ARTS-Laboratory/SCUWLS/system_design/Georgetown/V0.5.2/bill_of_materials.xlsx

Part Designator | Component | manufacturer part number | Amount | Unit | Individual Cost | Total Cost | Vendor 1 | Vendor 2 | Vendor 3 | Vendor 4 | Vendor 5 | Vendor 6
Nano every | Arduino Nano every |  | 1 | Pc | $12.90 | $12.90 | https://www.digikey.com/en/products/detail/arduino/ABX00028/10239971 | https://store-usa.arduino.cc/products/nano-every | https://www.sparkfun.com/arduino-nano-every.html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
P1 (Micro SD card slot) | 112J-TDAR-R01, 9 (8 + 1) Position Card Connector Secure Digital - microSD™ Surface Mount, Right Angle Gold |  | 1 | Pc | $2.52 | $2.52 | https://www.digikey.com/en/products/detail/attend-technology/112J-TDAR-R01/17634680 | https://www.ebay.com/itm/235081679206?chn=ps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
NRF24L01+ | NRF24L01+ 2.4GHz Wireless RF Transceiver Module |  | 1 | Pc | $3.95 | $3.95 | https://protosupplies.com/product/nrf24l01palna-2-4ghz-rf-wireless-module/
U2 (DS3231) | DS3231M+ real-time clock IC |  | 1 | Pc | $11.96 | $11.96 | https://www.digikey.com/en/products/detail/analog-devices-inc-maxim-integrated/DS3231M/2402420
U4 (BME280) | BME280 Pressure, Temperature and Humidity sensor |  | 1 | Pc | $5.26 | $5.26 | https://www.ebay.com/itm/327147846952?_skw=BME280+5+V&itmmeta=01KZVT1RTW26G1WWC3Y7NSNY2T | https://www.amazon.com/Onyehn-Temperature-Humidity-Barometric-Pressure/dp/B07KR24P6P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 | https://www.ebay.com/itm/223602242983?chn=ps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 | https://www.ebay.com/itm/183678893844?chn=ps&google_free_listing_action=view_item&gQT=2 | https://protosupplies.com/product/bme280-i2c-pressure-humidity-temperature-sensor-module/
U3 | Mini Pushbutton Power Switch with Reverse Voltage Protection, LV |  | 1 | Pc | $4.95 | $4.95 | https://www.digikey.com/en/products/detail/pololu/2808/10450608 | https://www.pololu.com/product/2808
N42 permanent magnet | Neodymium Disc Magnet - 1 1/4" Dia x 3/8" Thi |  | 1 | Pc | $15.20 | $15.20 | https://www.kjmagnetics.com/dx46-neodymium-disc-magnet
Ultrasonic sensor | HC-SR04 |  | 1 | Pc | $5.25 | $5.25 | Ultrasonic Distance Sensor - 5V (HC-SR04) (https://www.sparkfun.com/ultrasonic-distance-sensor-hc-sr04.html) | https://www.digikey.com/en/products/detail/adafruit-industries-llc/3942/9658069?gclsrc=aw.ds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 | https://www.ebay.com/itm/192312930293?chn=ps&google_free_listing_action=view_item
2s 7.4V LiPo battery | 2S Lipo Battery 1500mAh 7.4V with Deans Plug, Dim: 69*35*18mm |  | 1 | Pc | $18.00 | $18.00 | https://zeeebattery.com/products/zeee-7-4v-60c-1500mah-2s-lipo-battery-deans-plug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 | https://www.ebay.com/itm/383205406858
CR-1025 3V Li+ coin cell | CR-1025-ND |  | 1 | Pc | $1.09 | $1.09 | CR1025 Jauch Quartz | Battery Products | DigiKey (https://www.digikey.com/en/products/detail/jauch-quartz/CR1025/16399048) | https://www.ebay.com/itm/365610739537?chn=ps&google_free_listing_action=view_item
BT1 (coin cell holder) | BK-870 |  | 1 | Pc | $0.58 | $0.58 | BK-870 MPD (Memory Protection Devices) | Battery Products | DigiKey (https://www.digikey.com/en/products/detail/mpd-memory-protection-devices/bk-870/3829737) | https://www.ebay.com/itm/133891769676?chn=ps&google_free_listing_action=view_item
Q1 | MMBT2222A NPN transistor |  | 1 | pc | $0.14 | $0.14 | https://www.digikey.com/en/products/detail/diotec-semiconductor/MMBT2222A/13163394
PCB stage height v0.5.2 | Main board |  | 1 | Pc | $8.23 | $8.23 | https://oshpark.com/
Micro SD card | 8GB Micro SD Card |  | 1 | Pc | $8.24 | $8.24 | https://www.staples.com/centon-micro-8gb-sdhc-memory-card-uhs1-5-pack-s1-msdhu1-8g-5-b/product_24298979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 | https://www.staples.com/transcend-8gb-microsdhc-memory-card-class-10-ts8gusdhc10/product_IM1LK3226 | https://www.cdwg.com/product/transcend-flash-memory-card-8-gb-microsd/3181432?pfm=srh | https://www.cdwg.com/product/kingston-industrial-flash-memory-card-8-gb-microsdhc-uhs-i/6669743?pfm=srh | https://business.walmart.com/ip/Gigastone-8GB-Micro-SD-Card-FHD-Video-UHS-I-U1-Class-10-Surveillance-Security-Action-Cameras-Drone-Dash-Cams-5-Pack-5x8GB-GS-2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 | https://www.amazon.com/Gigastone-10-Pack-Surveillance-Security-Action/dp/B0876H387X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
SW1 (Slide switch) | 450301014042, Slide Switch SPDT Through Hole |  | 1 | Pc | $2.03 | $2.03 | https://www.digikey.com/en/products/detail/w%C3%BCrth-elektronik/450301014042/5209104 | https://www.mouser.com/ProductDetail/Wurth-Elektronik/450301014042?qs=wr8lucFkNMW0uepaR4R%2Fww%3D%3D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
D2 (LED) | L314ED, 3mm Red LED |  | 1 | Pc | $0.20 | $0.20 | L314ED American Opto Plus LED | Optoelectronics | DigiKey Marketplace (https://www.digikey.com/en/products/detail/american-opto-plus-led/L314ED/13677700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) | https://www.lvelectronics.com/details/item?itemid=AOP%20L314ED
R3, R5, R12 | RES SMD (10k) OHM 1% 1/4W 1206 |  | 3 | Pc | $0.10 | $0.30 | https://www.digikey.com/en/products/detail/yageo/RC1206FR-0710KL/728483
R6, R8, R10 | RES SMD (2K) OHM 1% 1/4W 1206 |  | 3 | Pc | $0.10 | $0.30 | https://www.digikey.com/en/products/detail/bourns-inc/CR1206-FX-2001ELF/2562846 | https://www.mouser.com/ProductDetail/KOA-Speer/RK73H2BLTD2001F?qs=iGskpj9dRIVPlylmUlAzCg%3D%3D
R1, R7, R9, R11 | RES SMD (1k) OHM 1% 1/4W 1206 |  | 4 | Pc | $0.10 | $0.40 | https://www.digikey.com/en/products/detail/bourns-inc/CR1206-FX-1001ELF/2562677 | https://www.mouser.com/ProductDetail/YAGEO/SR1206FR-071KL?qs=k2KEx2DUIRRzYfz4yJHffA%3D%3D
R2, R4 | RES SMD (100k) OHM 1% 1/4W 1206 |  | 2 | Pc | $0.10 | $0.20 | https://www.digikey.com/en/products/detail/yageo/RC1206FR-07100KL/728492
D1 (schottky) | Diode 20 V 1A Surface Mount 1206 (3216 Metric) |  | 1 | Pc | $0.39 | $0.39 | https://www.digikey.com/en/products/detail/kyocera-avx/SD1206T020S1R0/3749511 | https://www.mouser.com/ProductDetail/KYOCERA-AVX/SD1206T020S1R0?qs=jCA%252BPfw4LHaOj8Rzt48dmw%3D%3D
C3 (polarized) | 22 µF Molded Tantalum Capacitors 6.3 V 1206 (3216 Metric) 3Ohm |  | 1 | Pc | $0.41 | $0.41 | https://www.digikey.com/en/products/detail/kyocera-avx/TAJA226K006RNJ/1126793 | https://www.mouser.com/ProductDetail/KYOCERA-AVX/TAJA226K006RNJ?qs=QtLZGLLAmDbrbL0%252BYUNp1A%3D%3D
C5 | 10 µF 25 V Aluminum Electrolytic Capacitors Radial, Can 1000 Hrs @ 85°C |  | 1 | Pc | $0.26 | $0.26 | https://www.digikey.com/en/products/detail/panasonic-electronic-components/ECE-A1EKS100B/2689095 | https://www.mouser.com/ProductDetail/Panasonic/ECE-A1EKS100B?qs=rMMd5vBiahpNSBku%2FPA9KQ%3D%3D
C1, C2, C4, C6 | C1206S104K5RACAUTO 0.1 uF 10% 50V Ceramic Capacitor X7R 1206 (3216 Metric) |  | 4 | Pc | $0.48 | $1.92 | C1206S104K5RACAUTO KEMET | Capacitors | DigiKey (https://www.digikey.com/en/products/detail/kemet/c1206s104k5racauto/10232834) | https://www.mouser.com/ProductDetail/KEMET/C1206S104K5RACAUTO?qs=ds50AKTGxA9C%252BOGFjvBCPg%3D%3D
U5 | Linear Voltage Regulator IC Positive Fixed 1 Output 500mA SOT-223-3 |  | 1 | Pc | $3.58 | $3.58 | MIC5239-5.0YS-TR Microchip Technology | Integrated Circuits (ICs) | DigiKey (https://www.digikey.com/en/products/detail/microchip-technology/mic5239-5-0ys-tr/2346595) | https://www.microchipdirect.com/product/MIC5239-5.0YS-TR | https://www.mouser.com/ProductDetail/Microchip-Technology/MIC5239-5.0YS-TR?qs=U6T8BxXiZAVR02O8mv9RNQ%3D%3D
PVC pipe | Schedule 40 Clear Pipe, Non-threaded |  | 1 | Pc | $60.76 | $60.76 | https://www.grainger.com/product/1AAZ8?gclsrc=aw.ds&gad_source=1&gad_campaignid=21375667808
Female HC-SR04 connector | SSA-104-W-T, 4 pin connector |  | 1 | Pc | $0.91 | $0.91 | SSA-104-W-T Samtec Inc. | Connectors, Interconnects | DigiKey (https://www.digikey.com/en/products/detail/samtec-inc/ssa-104-w-t/1105908) | https://www.samtec.com/products/ssa-104-w-t
U1 (BMS) | HX-2S-JH10 |  | 1 | Pc | $2.15 | $2.15 | https://www.ebay.com/itm/122175451692?_skw=2s+7.4v+bms&itmmeta=01JC4ZYQC0WA4Q7FSXJ13Q3MD7 | https://www.ebay.com/itm/386425796959?itmmeta=01JX0567N9MHM61DNDR0TWAKGV
J2 (solar) | B2B-XH-A, 2.54mm JST 2 pin |  | 1 | Pc | $0.10 | $0.10 | https://www.digikey.com/en/products/detail/jst-sales-america-inc/B2B-XH-A/1651045?gclsrc=aw.ds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
J1 (Lipo) | B3B-XH-A, 2.54mm JST 3 pin |  | 1 | Pc | $0.13 | $0.13 | https://www.digikey.com/en/products/detail/jst-sales-america-inc/B3B-XH-A/1651046?gad_source=1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 | https://www.ebay.com/itm/135516167050?_skw=B3B-XH-A&itmmeta=01JXJN27KW3SV3ZA95H65390XD
Solar panels | SM141K06TF |  | 9 | Pc | $7.39 | $66.51 | https://www.digikey.com/en/products/detail/anysolar-ltd/SM141K06TF/14311398
 | M3 Hex nut |  | 2 | Pc | $0.01 | $0.02
 | M3 screw |  | 2 | Pc | $0.01 | $0.02
 | M2 hex nut |  | 2 | Pc | $0.01 | $0.02 | https://www.grainger.com/product/Hex-Nut-M2-0-40-Thread-6CA66
 | M2 screw |  | 4 | Pc | $0.07 | $0.29 | https://www.grainger.com/product/Machine-Screws-M2x0-40-Thread-6GY22?
O-Rings | O-Ring: Buna-N, Round, 2 mm C.S., 35 mm I.D. |  | 1 | Pc | $2.68 | $2.68 | https://www.grainger.com/product/O-Ring-Buna-N-41KW27
Chipolo tracker | Chipolo POP |  | 1 | Pc | $25.00 | $25.00 | https://chipolo.net/en-us/products/chipolo-pop?variant=4000996
 |  |  |  |  | Total Cost | $266.85
