ARTS-Laboratory/SCUWLS/system_design/Georgetown/V0.5.2/EDA/main_board/main_board.kicad_pcb

## KiCad design system_design/Georgetown/V0.5.2/EDA/main_board/main_board.kicad_pcb (2026-09-16)

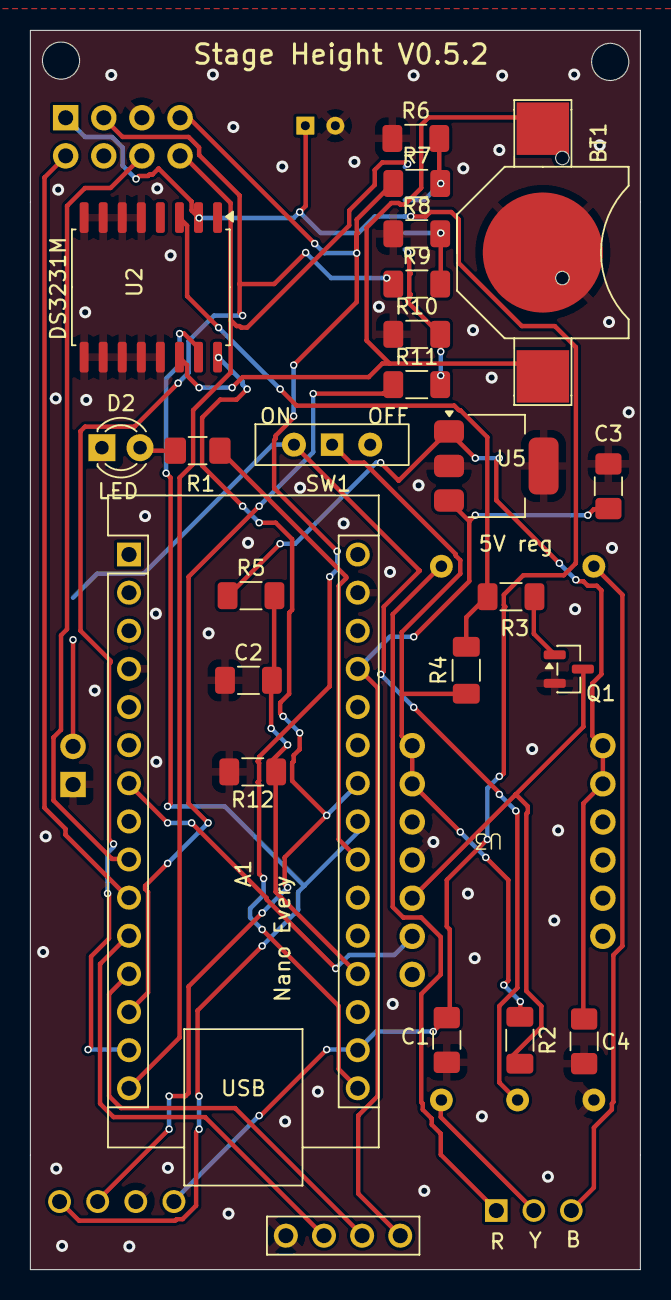
[picture p1: board main_board.kicad_pcb from above]

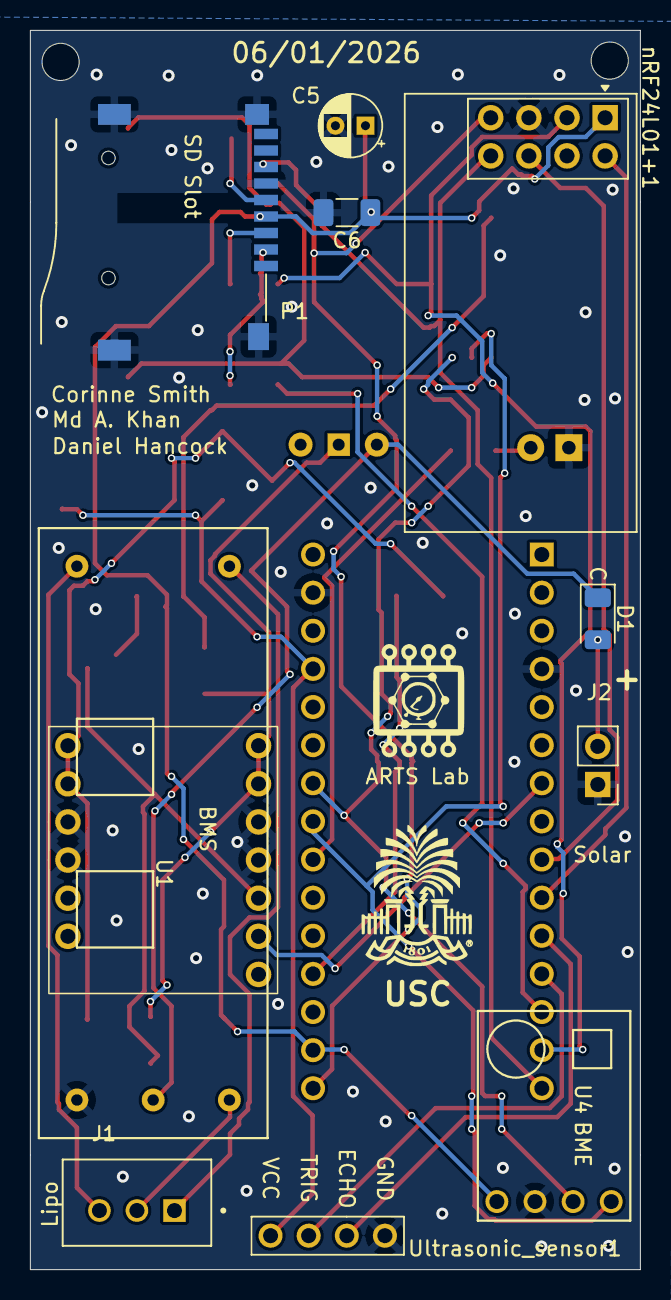
[picture p2: board main_board.kicad_pcb from below]

Board: 2 copper layers, 40.6 x 82.6 mm, 36 parts (13 on the bottom side), 31 nets.

Parts:
A1: Arduino_Nano_v2.x-MCU_Module; Arduino_Nano
ARTS Lab: LOGO
BT1: Battery_Cell; battery_holder_10mm
C1, C4: 0.1uF; C_1206_3216Metric_Pad1.42x1.75mm_HandSolder
C2, C6: 0.1uF; C_1206_3216Metric_Pad1.33x1.80mm_HandSolder
C3: 22uF; C_1206_3216Metric_Pad1.42x1.75mm_HandSolder
C5: 10uF; CP_Radial_D4.0mm_P2.00mm
D1: D_Schottky; D_1206_3216Metric
D2: LED; LED_D3.0mm
J1: B3B-XH-A_LF__SN_; XH2.54
J2: Conn_01x02_Pin; PinHeader_1x02_P2.54mm_Vertical
P1: SD card socket; SUNTECH_ST-TF-003A
Q1: MMBT2222A; SOT-23
R1: 1k; C_1206_3216Metric_Pad1.42x1.75mm_HandSolder
R2, R4: 100k; C_1206_3216Metric_Pad1.33x1.80mm_HandSolder
R3, R5, R12: 10k; C_1206_3216Metric_Pad1.33x1.80mm_HandSolder
R6, R8, R10: 2K; C_1206_3216Metric_Pad1.33x1.80mm_HandSolder
R7, R9, R11: 1K; C_1206_3216Metric_Pad1.33x1.80mm_HandSolder
SW1: SW_Wuerth_450301014042; SW_Slide-03_Wuerth-WS-SLTV_10x2.5x6.4_P2.54mm
U1: HX-2S-JH10
U2: DS3231M; SOIC-16W_7.5x10.3mm_P1.27mm
U3: Polou LV switch psw03a
U4: BME280_module
U5: KA78M05_TO252; SOT-223-3_TabPin2
USC: UofSC; LOGO
Ultrasonic_sensor1: HCSR04
nRF24L01+1: nRF24L01+; nRF24L01_Breakout

Connections:
3V3: A1.17 (3V3), C1.1, C5.1, C6.1, P1.4 (VDD), U2.2 (VCC), U4.1 (VIN), nRF24L01+1.1 (3.3V)
5V: A1.27 (+5V), C3.2, U5.3 (VO), Ultrasonic_sensor1.4 (VCC)
Alarm_INT: R3.2, R4.2, U2.3 (~INT/SQW)
GND: A1.4 (GND), A1.29 (GND), BT1.2 (-), C1.2, C2.1, C3.1, C4.1, C5.2, C6.2, D2.1 (K), J2.1, P1.6 (VSS), P1.G1 (GND), P1.G2 (GND), P1.G3 (GND), P1.G4 (GND), Q1.2 (E), R6.1, R8.1, R10.1, R12.2, U1.1 (P-), U2.5 (GND), U2.6 (GND), U2.7 (GND), U2.8 (GND), U2.9 (GND), U2.10 (GND), U2.11 (GND), U2.12 (GND), U2.13 (GND), U3.3 (GND), U3.4 (GND), U3.9 (GND), U3.10 (GND), U4.2 (GND), U5.2 (GND), Ultrasonic_sensor1.1 (GND), nRF24L01+1.5 (GND)
MISO: A1.15 (D12), P1.7 (DAT0/MISO), nRF24L01+1.8 (MISO)
MOSI: A1.14 (D11), R9.1, nRF24L01+1.3 (MOSI)
unnamed: A1.19 (A0), C2.2, R5.2, R12.1
unnamed: A1.22 (A3), R1.1
unnamed: A1.23 (A4), U2.15 (SDA), U4.4 (SDA)
unnamed: A1.24 (A5), U2.16 (SCL), U4.3 (SCL)
unnamed: A1.7 (D4), U3.12 (Off)
unnamed: A1.11 (D8), Ultrasonic_sensor1.2 (ECHO)
unnamed: A1.12 (D9), Ultrasonic_sensor1.3 (TRIG)
unnamed: BT1.1 (+), U2.14 (VBAT)
unnamed: D1.2 (A), J2.2
unnamed: D1.1 (K), SW1.2 (C), U1.2 (P+)
unnamed: D2.2 (A), R1.2
unnamed: P1.5 (CLK/SCK), R6.2, R7.2
unnamed: P1.3 (CMD/MOSI), R8.2, R9.2
unnamed: P1.2 (DAT3/CS), R10.2, R11.2
unnamed: Q1.1 (B), R3.1
unnamed: Q1.3 (C), R2.2, U3.11 (On)
unnamed: R2.1, R4.1, SW1.1 (B), U3.7 (Vin), U3.8 (Vin)
unnamed: J1.1, U1.5 (B+)
unnamed: J1.3, U1.3 (B-)
unnamed: J1.2, U1.4 (BM)
unnamed: C4.2, R5.1, U3.1 (Vout), U3.2 (Vout), U5.1 (VI)
SCK: A1.16 (D13), R7.1, nRF24L01+1.7 (SCK)
SD_CS: A1.13 (D10), R11.1
nRF_CE: A1.9 (D6), nRF24L01+1.6 (CE)
nRF_CS: A1.10 (D7), nRF24L01+1.2 (CSN)
