ARTS-Laboratory/SCUWLS/(commit log)

2026-09-16 BOM and PCB edited for Nano every
    [bill_of_materials.xlsx, main_board.kicad_pcb]
2026-09-17 Updated BOM
    [bill_of_materials.xlsx]
2026-09-22 BOM correction
    [bill_of_materials.xlsx]
2026-09-23 Code tidied up
    [data_headers_to_be transmitted.csv]
2026-10-20 BOM edited
2026-10-28 wireless comm to main program
